kuro68k/Neo-Geo-Adapter/CAD/Playstation Controller Socket (3rd party).FCStd

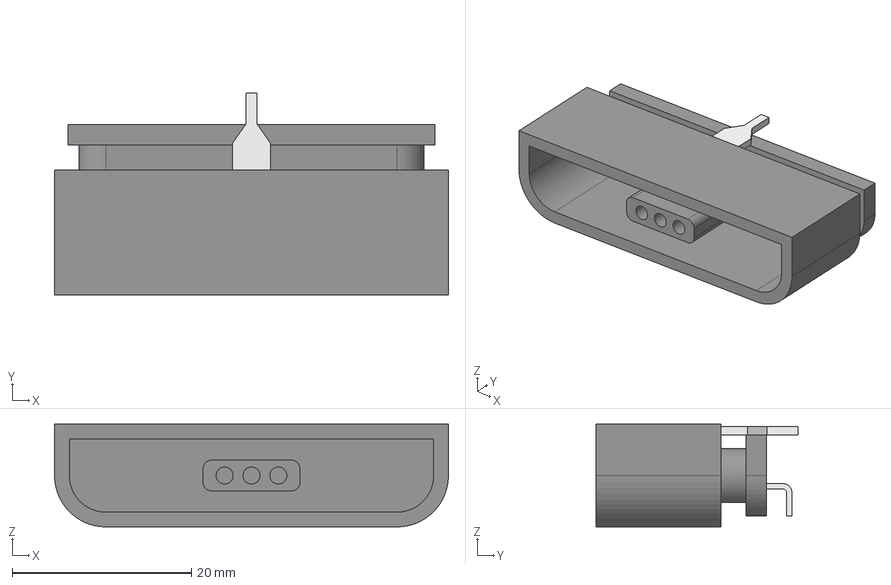
[picture p1: CAD file, 2024-02-19]
CAD/Playstation Controller Socket (3rd party).FCStd
44.0 x 22.6 x 11.5 mm
Body Plastic Shell
Body Rear Contacts
Body Front Contact Shell
Body Rear Ground Contact
