kuro68k/Neo-Geo-Adapter/hardware - top board/plot/Top Board.step

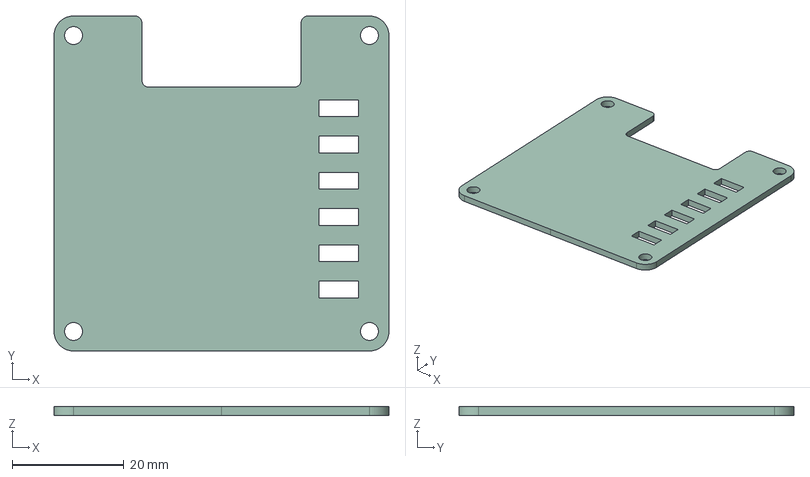
[picture p2: CAD file, 2024-04-19]
hardware - top board/plot/Top Board.step
60.0 x 60.0 x 1.60 mm
Top Board_pad_1
Top Board_pad_2
Top Board_pad_3
Top Board_pad_4
Top Board_pad_5
Top Board_pad_6
Top Board_pad_7
Top Board_pad_8
Top Board_PCB
