kuro68k/Neo-Geo-Adapter/CAD/Saturn Controller Socket (3rd party).FCStd

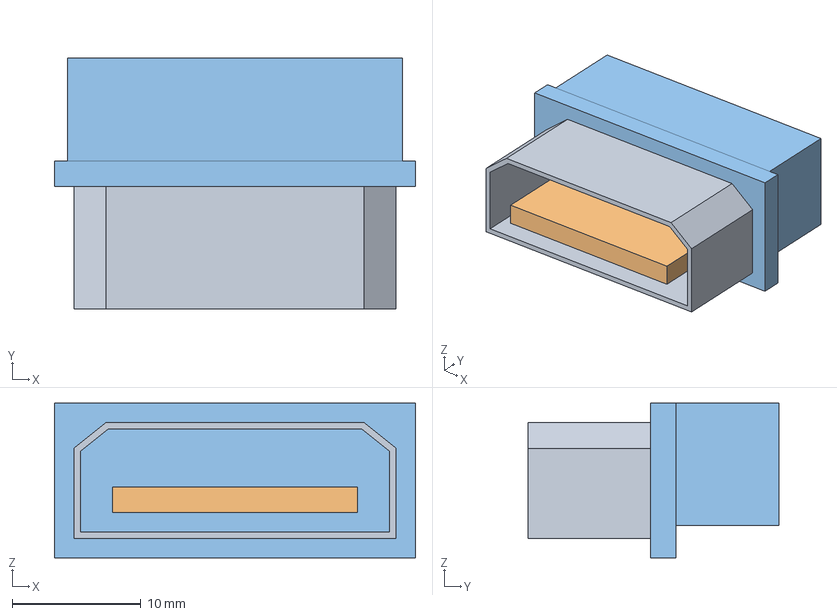
[picture p3: CAD file, 2024-02-19]
CAD/Saturn Controller Socket (3rd party).FCStd
28.0 x 19.5 x 12.0 mm
Contact Shell
Contact Tongue
Strain Relief
