kuro68k/Neo-Geo-Adapter/CAD/XKB SS13D75L5.stp

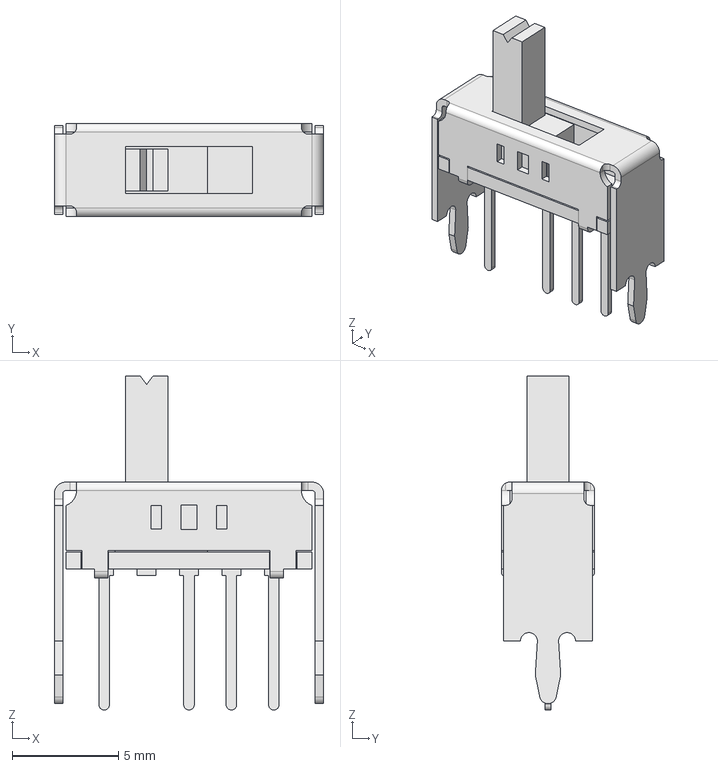
[picture p4: CAD file, 2024-02-19]
CAD/XKB SS13D75L5.stp
12.7 x 4.40 x 15.7 mm
