kuro68k/Neo-Geo-Adapter/hardware/Neo Geo Adapter.pdf

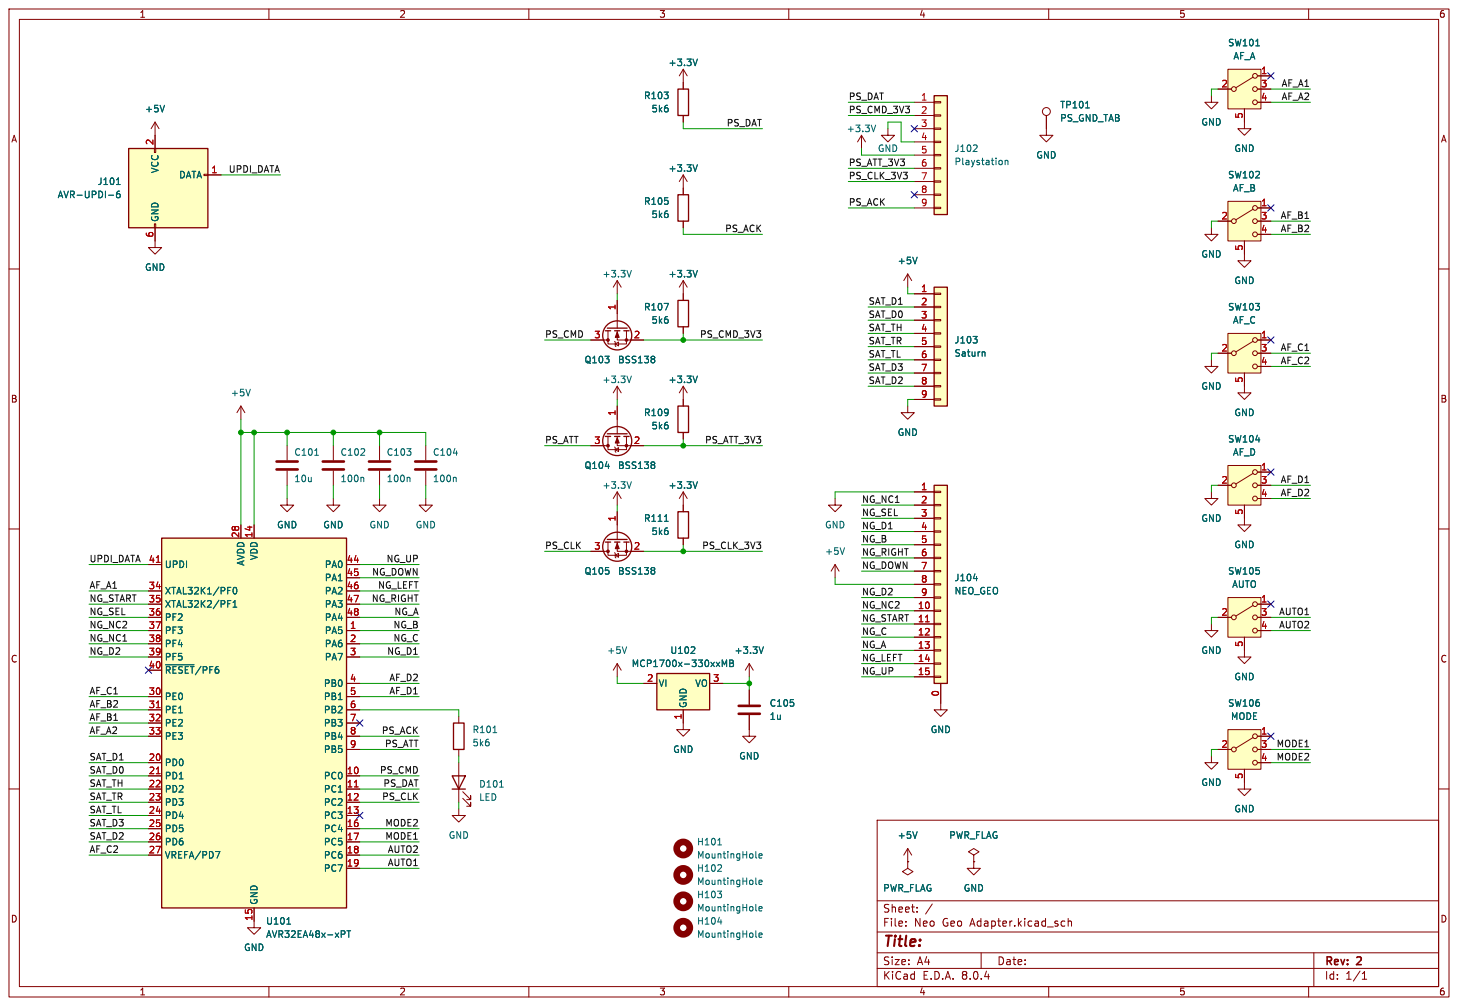
[picture p5: page 1]

PWR_FLAG
Id: 1/1 Title: File: Neo Geo Adapter.kicad_sch Sheet: /
