kuro68k/Neo-Geo-Adapter/hardware/Neo Geo Adapter.kicad_pcb

## KiCad design hardware/Neo Geo Adapter.kicad_pcb (2024-08-27)

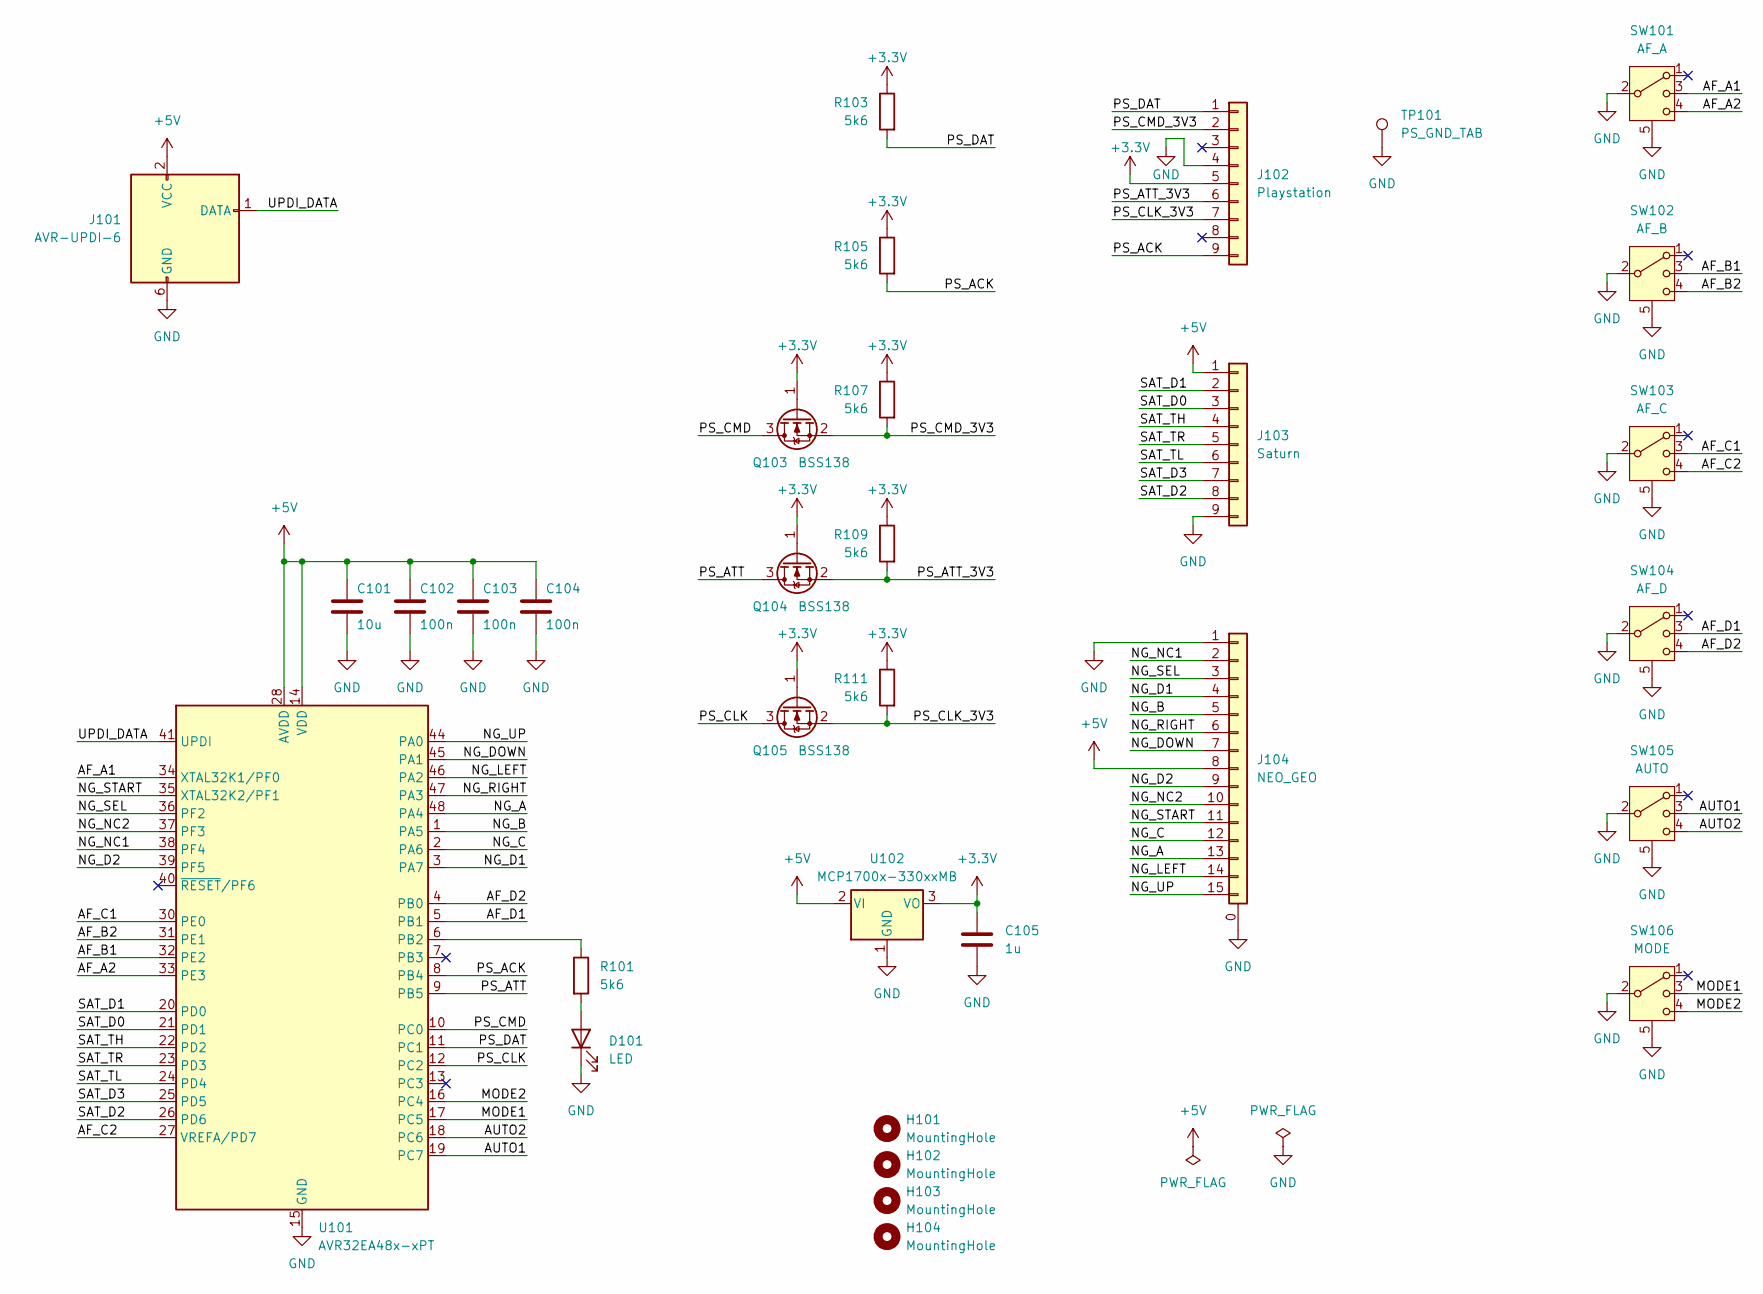
[picture p6: schematic Neo Geo Adapter.kicad_sch]

Parts:
C101: 10u; C_0805_2012Metric_Pad1.18x1.45mm_HandSolder
C102, C103, C104: 100n; C_0805_2012Metric_Pad1.18x1.45mm_HandSolder
C105: 1u; C_0805_2012Metric_Pad1.18x1.45mm_HandSolder
D101: LED; LED_0805_2012Metric_Pad1.15x1.40mm_HandSolder
H101, H102, H103, H104: MountingHole; MountingHole_3.2mm_M3
J101: AVR-UPDI-6; PinHeader_2x03_P1.27mm_Vertical_SMD
J102: Playstation; Sony_Playstation
J103: Saturn; Sega_Saturn
J104: NEO_GEO; DSUB-15_Female_Horizontal_P2.77x2.84mm_EdgePinOffset7.70mm_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; MPN Amphenol L77SDA15SA4CH4F
Q103, Q104, Q105: BSS138; SOT-23
R101, R103, R105, R107, R109, R111: 5k6; R_0805_2012Metric_Pad1.20x1.40mm_HandSolder
SW101: AF_A; XKB_SS13D75
SW102: AF_B; XKB_SS13D75
SW103: AF_C; XKB_SS13D75
SW104: AF_D; XKB_SS13D75
SW105: AUTO; XKB_SS13D75
SW106: MODE; XKB_SS13D75
TP101: PS_GND_TAB; TestPoint_THTPad_D2.5mm_Drill1.2mm
U101: AVR32EA48x-xPT; TQFP-48_7x7mm_P0.5mm
U102: MCP1700x-330xxMB; SOT-89-3

Connections:
+3.3V: C105.1, J102.5, Q103.1 (G), Q104.1 (G), Q105.1 (G), R103.1, R105.1, R107.1, R109.1, R111.1, U102.3 (VO)
+5V: C101.1, C102.1, C103.1, C104.1, J101.2 (VCC), J103.1, J104.8, U101.14 (VDD), U101.28 (AVDD), U101.42 (VDD), U102.2 (VI)
/AF_A1: SW101.3, U101.34 (XTAL32K1/PF0)
/AF_A2: SW101.4, U101.33 (PE3)
/AF_B1: SW102.3, U101.32 (PE2)
/AF_B2: SW102.4, U101.31 (PE1)
/AF_C1: SW103.3, U101.30 (PE0)
/AF_C2: SW103.4, U101.27 (VREFA/PD7)
/AF_D1: SW104.3, U101.5 (PB1)
/AF_D2: SW104.4, U101.4 (PB0)
/AUTO1: SW105.3, U101.19 (PC7)
/AUTO2: SW105.4, U101.18 (PC6)
/MODE1: SW106.3, U101.17 (PC5)
/MODE2: SW106.4, U101.16 (PC4)
/NG_A: J104.13, U101.48 (PA4)
/NG_B: J104.5, U101.1 (PA5)
/NG_C: J104.12, U101.2 (PA6)
/NG_D1: J104.4, U101.3 (PA7)
/NG_D2: J104.9, U101.39 (PF5)
/NG_DOWN: J104.7, U101.45 (PA1)
/NG_LEFT: J104.14, U101.46 (PA2)
/NG_NC1: J104.2, U101.38 (PF4)
/NG_NC2: J104.10, U101.37 (PF3)
/NG_RIGHT: J104.6, U101.47 (PA3)
/NG_SEL: J104.3, U101.36 (PF2)
/NG_START: J104.11, U101.35 (XTAL32K2/PF1)
/NG_UP: J104.15, U101.44 (PA0)
/PS_ACK: J102.9, R105.2, U101.8 (PB4)
/PS_ATT: Q104.3 (D), U101.9 (PB5)
/PS_ATT_3V3: J102.6, Q104.2 (S), R109.2
/PS_CLK: Q105.3 (D), U101.12 (PC2)
/PS_CLK_3V3: J102.7, Q105.2 (S), R111.2
/PS_CMD: Q103.3 (D), U101.10 (PC0)
/PS_CMD_3V3: J102.2, Q103.2 (S), R107.2
/PS_DAT: J102.1, R103.2, U101.11 (PC1)
/SAT_D0: J103.3, U101.21 (PD1)
/SAT_D1: J103.2, U101.20 (PD0)
/SAT_D2: J103.8, U101.26 (PD6)
/SAT_D3: J103.7, U101.25 (PD5)
/SAT_TH: J103.4, U101.22 (PD2)
/SAT_TL: J103.6, U101.24 (PD4)
/SAT_TR: J103.5, U101.23 (PD3)
/UPDI_DATA: J101.1 (DATA), U101.41 (UPDI)
GND: C101.2, C102.2, C103.2, C104.2, C105.2, D101.1 (K), J101.6 (GND), J102.4, J103.9, J104.0 (Shell), J104.1, SW101.2, SW101.5 (Shell), SW102.2, SW102.5 (Shell), SW103.2, SW103.5 (Shell), SW104.2, SW104.5 (Shell), SW105.2, SW105.5 (Shell), SW106.2, SW106.5 (Shell), TP101.1, U101.15 (GND), U101.29 (GND), U101.43 (GND), U102.1 (GND)
unnamed: D101.2 (A), R101.2
unnamed: R101.1, U101.6 (PB2)

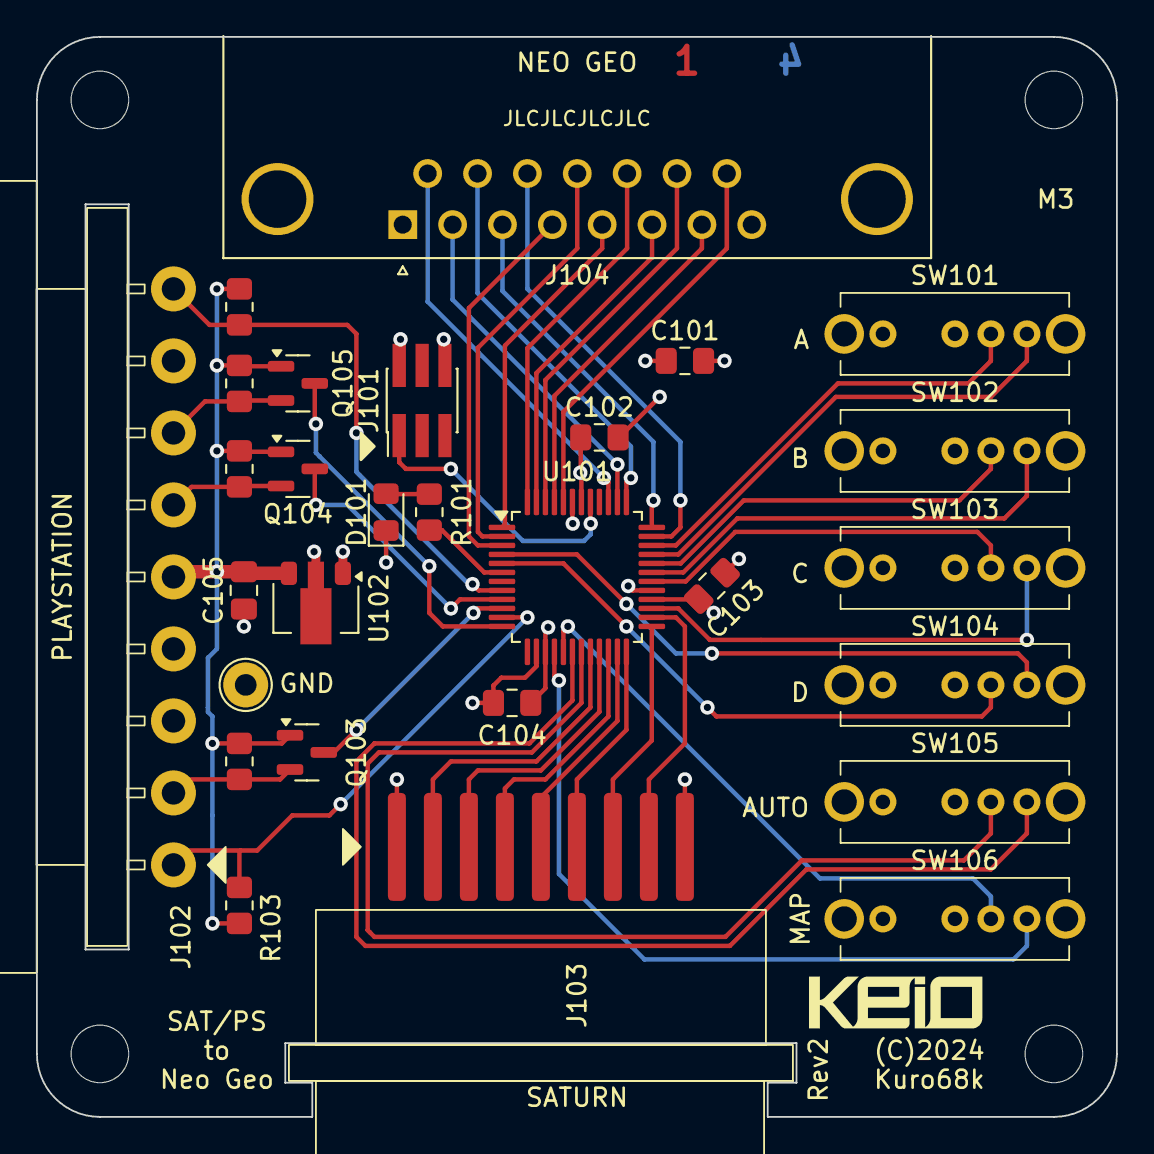
[picture p7: board Neo Geo Adapter.kicad_pcb from above]

Board: 4 copper layers, 60.0 x 60.0 mm, 32 parts (0 on the bottom side), 46 nets.
