kuro68k/Neo-Geo-Adapter/(commit log)

2024-04-11 Fixed PDI header gender, KiCad 8
    [Neo Geo Adapter.kicad_pcb, Neo Geo Adapter.kicad_sch]
2024-04-11 Added BOM
    [Neo Geo Adapter.kicad_sch]
2024-04-11 15 pin connector part and 3D model
    [Neo Geo Adapter.kicad_pcb, Neo Geo Adapter.kicad_sch]
2024-04-19 Added top board with labelling
    [Neo Geo Adapter.kicad_pcb, Top Board.kicad_pcb, Top Board.kicad_sch, Top Board.step]
2024-05-07 PCB artwork + output
    [Neo Geo Adapter.kicad_pcb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]
2024-05-29 Skip PS reading if not connected/error
    [main.c]
2024-05-29 Set fuses, minimum watchdog timeout
2024-06-03 Playstation 3V3 power and signalling
    [Neo Geo Adapter.kicad_pcb, Neo Geo Adapter.kicad_sch, Top Board.kicad_pcb]
2024-08-27 Rev 2 RTM
    [Bottom Board-B_Cu.gbr, Bottom Board-B_Mask.gbr, Bottom Board-B_Paste.gbr, Bottom Board-B_Silkscreen.gbr, Bottom Board-Edge_Cuts.gbr, Bottom Board-F_Cu.gbr, Bottom Board-F_Mask.gbr, Bottom Board-F_Paste.gbr]
