kuro68k/Neo-Geo-Adapter/(notices)

Notices in the files:
hardware - top board/Top Board.kicad_pcb:
(C)2024 Kuro68k
